gvi-blip/DISHA/Circuit Design.jpg

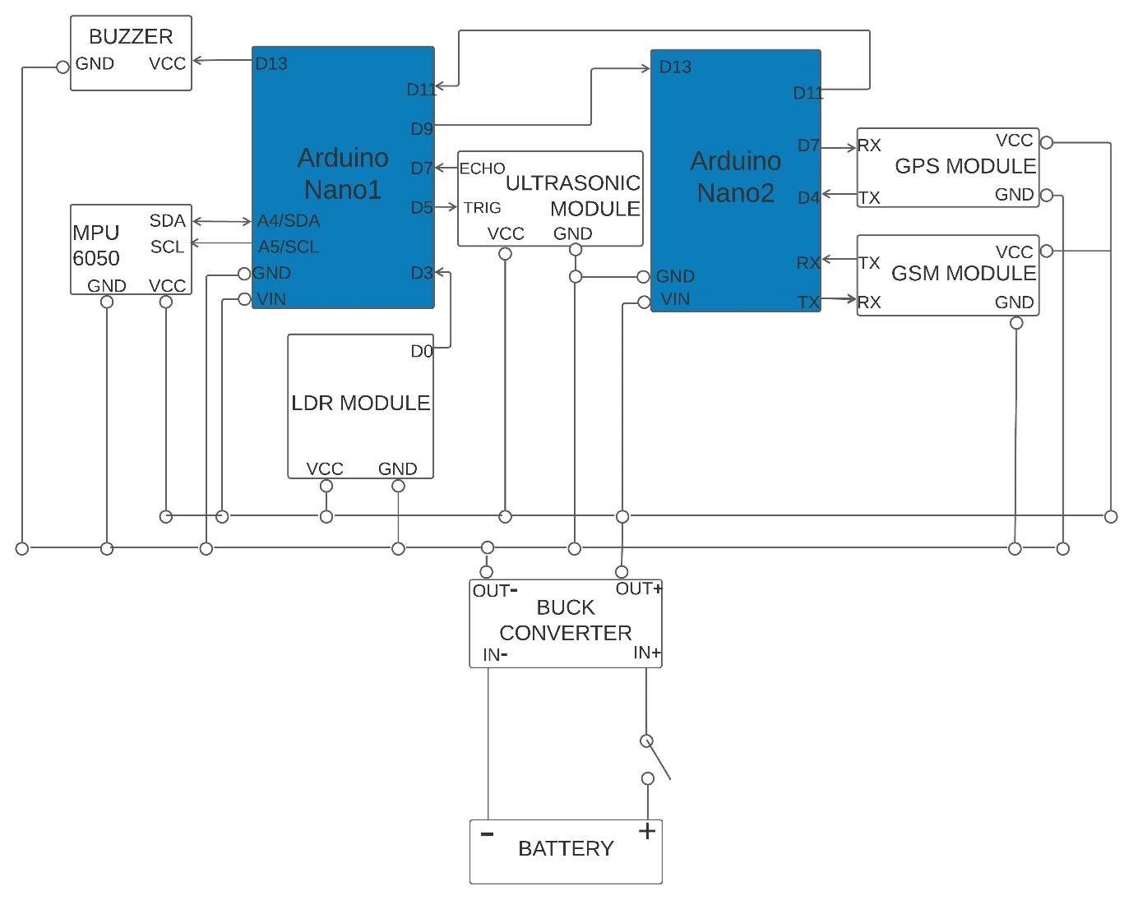
Circuit Design.jpg
