gvi-blip/DISHA/Flowchart for Board1.jpg

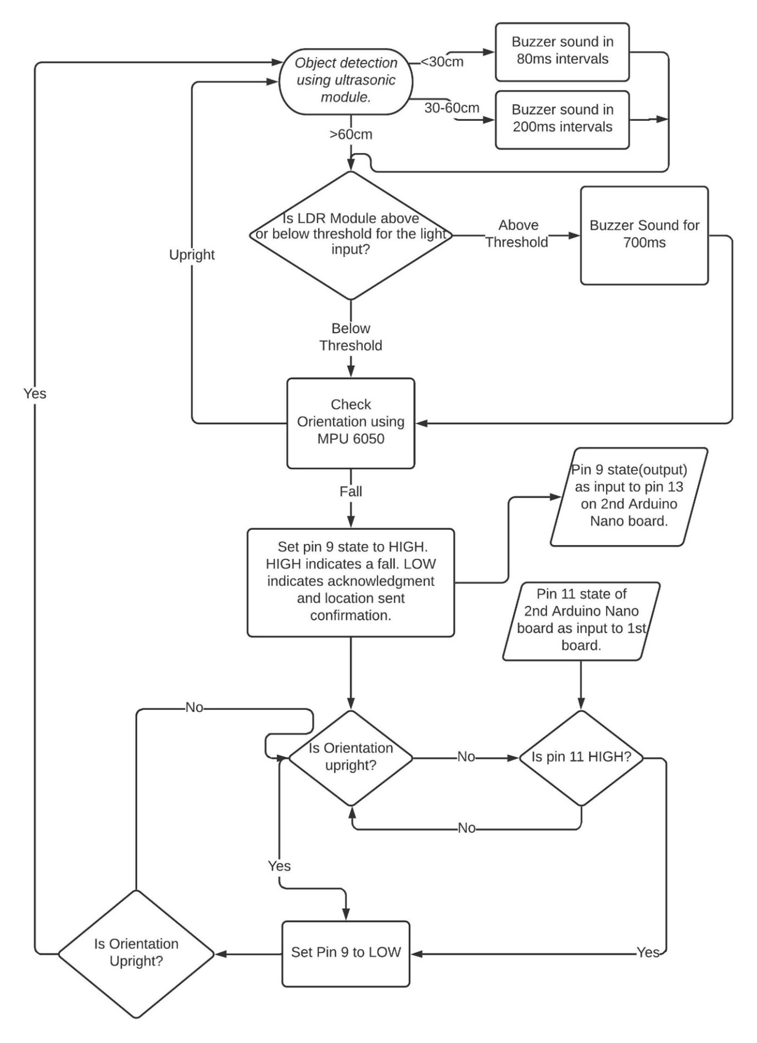
Flowchart for Board1.jpg
