gvi-blip/DISHA/Flowchart for Board2.jpg

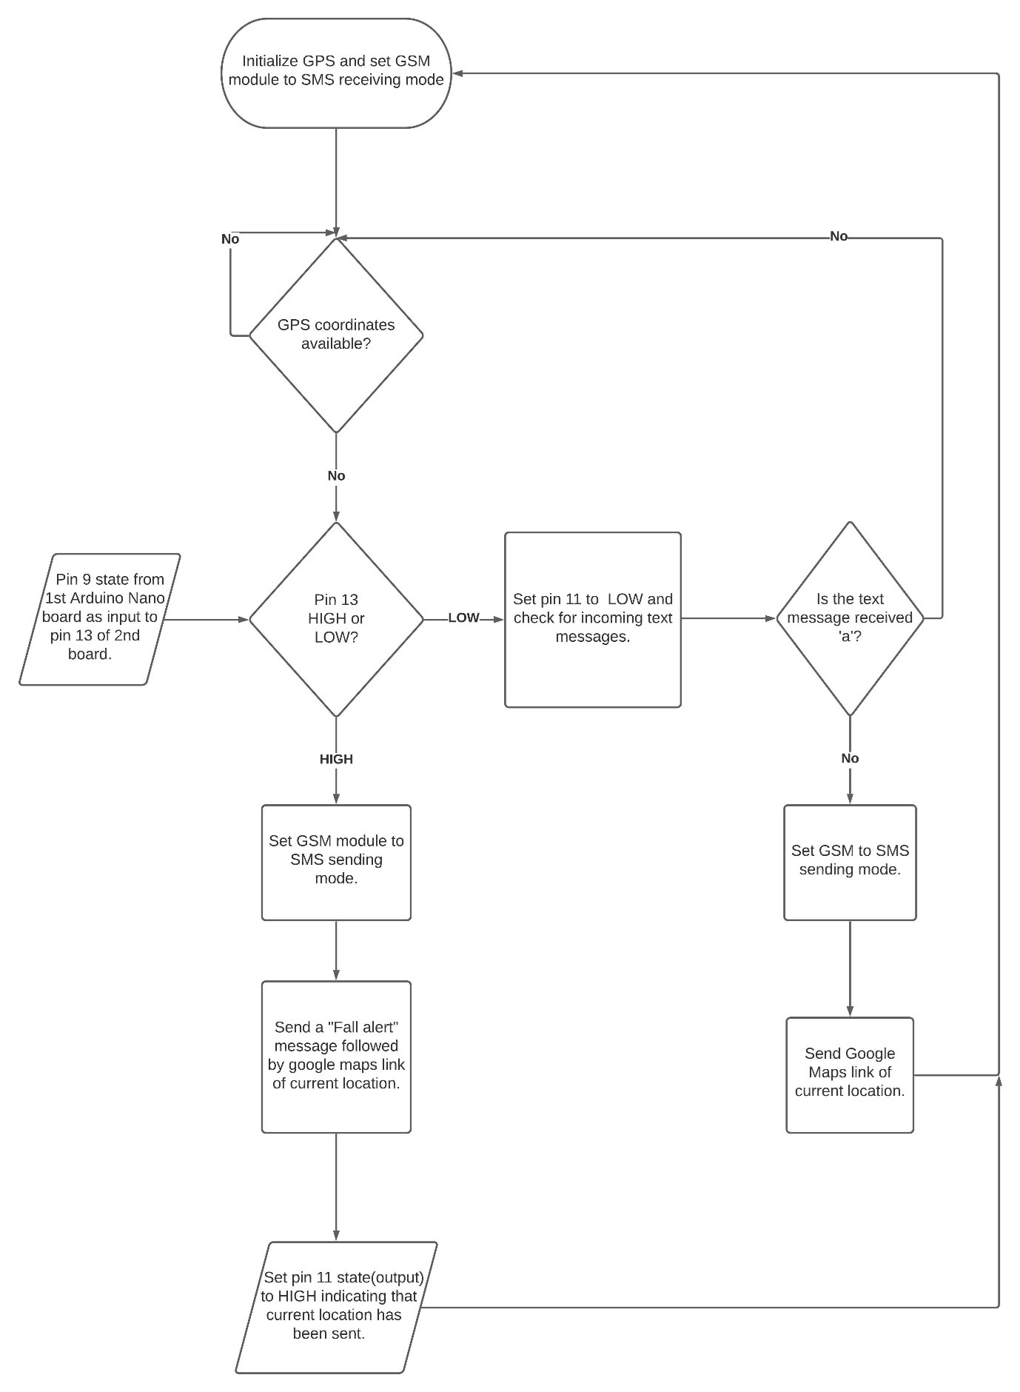
Flowchart for Board2.jpg
