gvi-blip/DISHA/Components.jpg

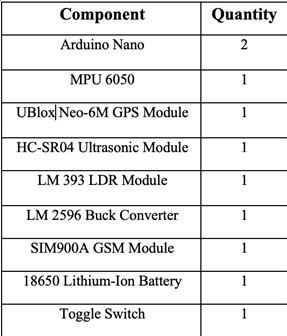
Components.jpg
